arihantexplains/build-lab-ep02-smart-plant-watering/docs/images/arduino-loop.png

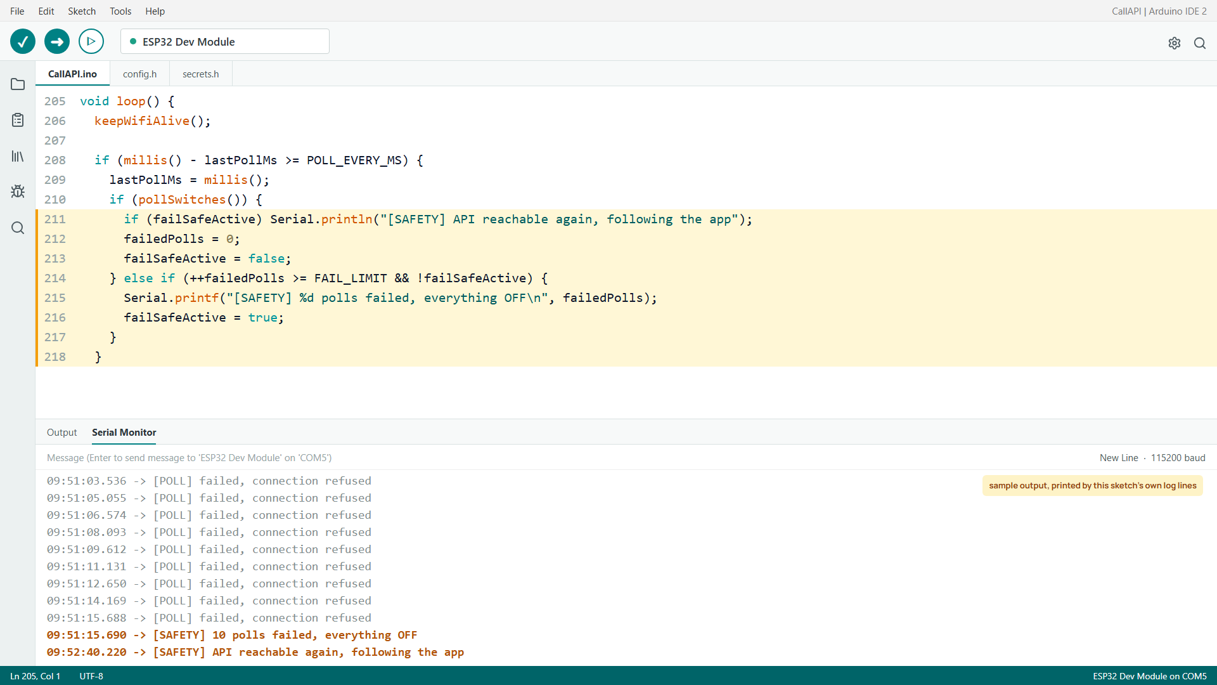
docs/images/arduino-loop.png
