arihantexplains/build-lab-ep02-smart-plant-watering/docs/images/send-whatsapp-message-table.png

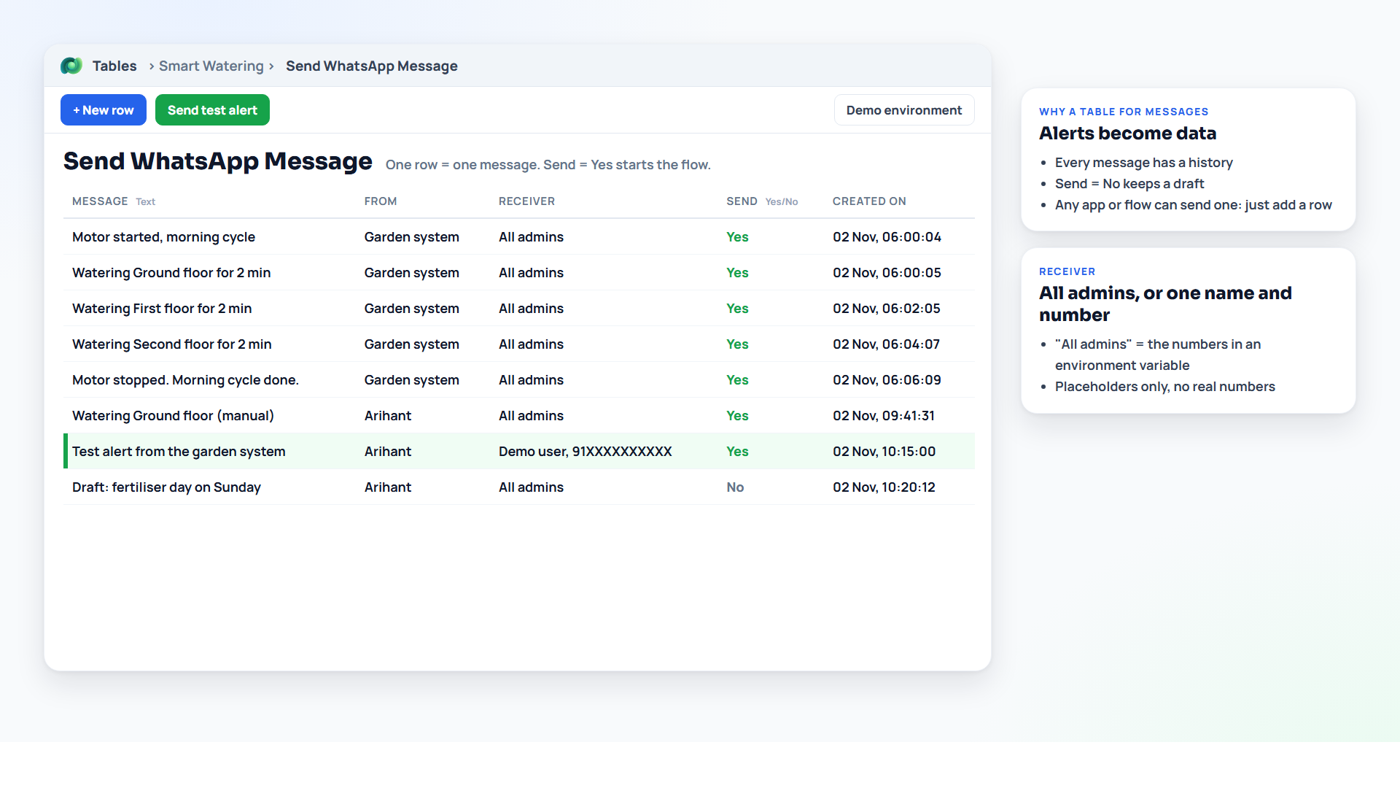
docs/images/send-whatsapp-message-table.png
