arihantexplains/build-lab-ep02-smart-plant-watering/docs/images/switch-command-table.png

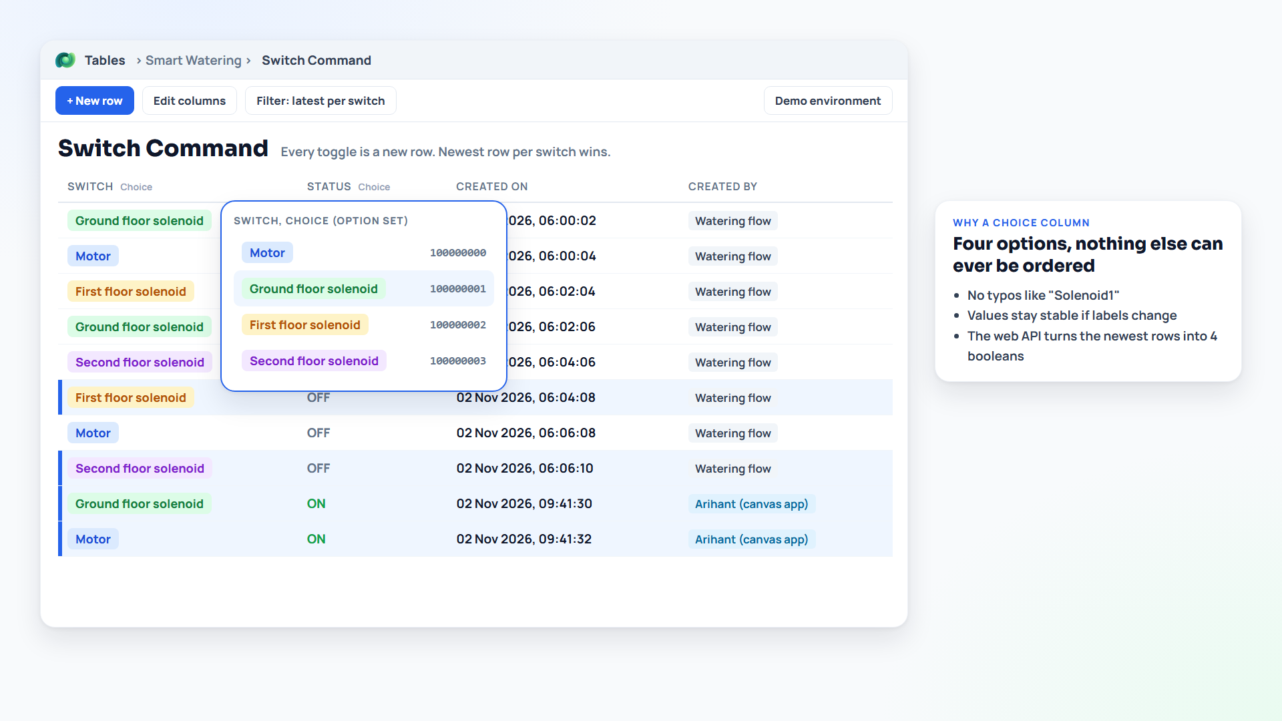
docs/images/switch-command-table.png
