arihantexplains/build-lab-ep02-smart-plant-watering/(commit log)

2026-11-02 Architect's Build Lab, Episode 4: Smart Plant Watering
    ESP32 sketch (one HTTPS call, four relays, safety on the board), Node web API
    (mock + Dataverse mode, optional Custom API read), C# Dataverse plugins for
    WhatsApp alerts and switch states with unit tests, Dataverse schema and script,
    flow and app walkthroughs, and docs: architecture, setup, placeholders,
    security, wiring, before and after.
2026-11-02 CallAPI v2: open the next tap before closing the previous one; add the video thumbnail and the updated flow image
2026-11-09 Architect's Build Lab Episode 2: repo name, README (wiring + run locally), EP 2 social preview and thumbnail
2026-11-09 Secret scan: gitleaks clean; document the sample mock device key
2026-11-09 README for publishing: banner, hook, how it works, safety rules on the board, series links; docs/permissions.md
2026-11-09 gitleaks config: allowlist only the documented sample device key
